hackup/WifiModem64/(threads)

Thread 1 (2020-01-26):

Board not connected

LordFennec, 2020-01-26:
Good morning.
I made a modemwifi board and loaded the latest firmware released (but I made them with both versions released), but when I try to connect to the home wifi, it always fails and does not connect. The configuration of the parameters are certainly correct.
On the ccmgs program I configured:
Modem type: user port 300-2400
Baud rate: 300
Duplex: full
Protocol: A punter

I made another type of modem with the nodemcu module and with these parameters everything works properly.

LordFennec, 2020-02-04:
Is there anyone who managed to make it work ??
