hackup/WifiModem64/WifiModem64.kicad_pcb

## KiCad design WifiModem64.kicad_pcb (2018-01-16)

Schematic: WifiModem64.sch

Parts:
C1: 100n; C_0805_HandSoldering
D1: B5819WS; D_SOD-323_HandSoldering
F1: 0.5A; R_1206_HandSoldering
J1: C64-UserPort; C64-User-Port-Female
J2: USB_B; USB_Micro-B
JP1: PwrSafety; GS2
JP2: CTS; GS2
JP3: RTS; GS2
JP4: SP1; GS2
JP5: SP2; GS2
JP6: PwrSrc; Pin_Header_Straight_1x03_Pitch2.54mm
LED1: WS2812B
Q1, Q2, Q3, Q4: BSS138; SOT-23_Handsoldering
R1, R2, R3, R4, R5, R6, R7, R8: 10k; R_0805_HandSoldering
SW1: Push; SW_Tactile_SPST_Angled_PTS645Vx58-2LFS
SW2: Reset; SW_Tactile_SPST_Angled_PTS645Vx58-2LFS
U1: WeMos_mini; D1_mini_board
U2: WeMos_D1_mini_OLED_Shield; D1_mini_OLED_Display

Connections:
+3V3: Q1.1, Q2.1, Q3.1, Q4.1, R1.1, R2.1, R3.1, R4.1, U1.16, U2.16 (3.3V)
+5V: C1.1, F1.1, JP1.1, LED1.1, R5.1, R6.1, R7.1, R8.1, U1.1, U2.1 (5V)
CTS: J1.D, JP2.1, Q1.2, R1.2
GND: C1.2, J1.1, J1.12, J1.A, J1.N, J2.4, J2.5, LED1.3, SW1.2, SW2.2, U1.2, U2.2 (GND)
unnamed: D1.1, F1.2
unnamed: D1.2, JP1.2, JP6.2
unnamed: J1.2, JP6.3
unnamed: J1.6, J1.L
unnamed: J2.1, JP6.1
RST: J1.3, SW2.1
RTS: J1.K, JP3.1, Q2.2, R2.2
SP1: J1.5, J1.M, JP4.1, Q3.2, R3.2
SP2: J1.7, J1.B, J1.C, JP5.1, Q4.2, R4.2
W_A0: U1.10, U2.10 (A0)
W_D0: U1.11, U2.11 (D0)
W_D1: U1.6, U2.6 (D1)
W_D2: U1.5, U2.5 (D2)
W_D3: SW1.1, U1.4, U2.4 (D3)
W_D4: U1.3, U2.3 (D4)
W_D5: LED1.4, U1.12, U2.12 (D5)
W_D6: JP2.2, Q1.3, R5.2, U1.13, U2.13 (D6)
W_D7: JP3.2, Q2.3, R6.2, U1.14, U2.14 (D7)
W_D8: U1.15, U2.15 (D8)
W_RST: U1.9, U2.9 (Rst)
W_RX: JP4.2, Q3.3, R7.2, U1.7, U2.7 (Rx)
W_TX: JP5.2, Q4.3, R8.2, U1.8, U2.8 (Tx)

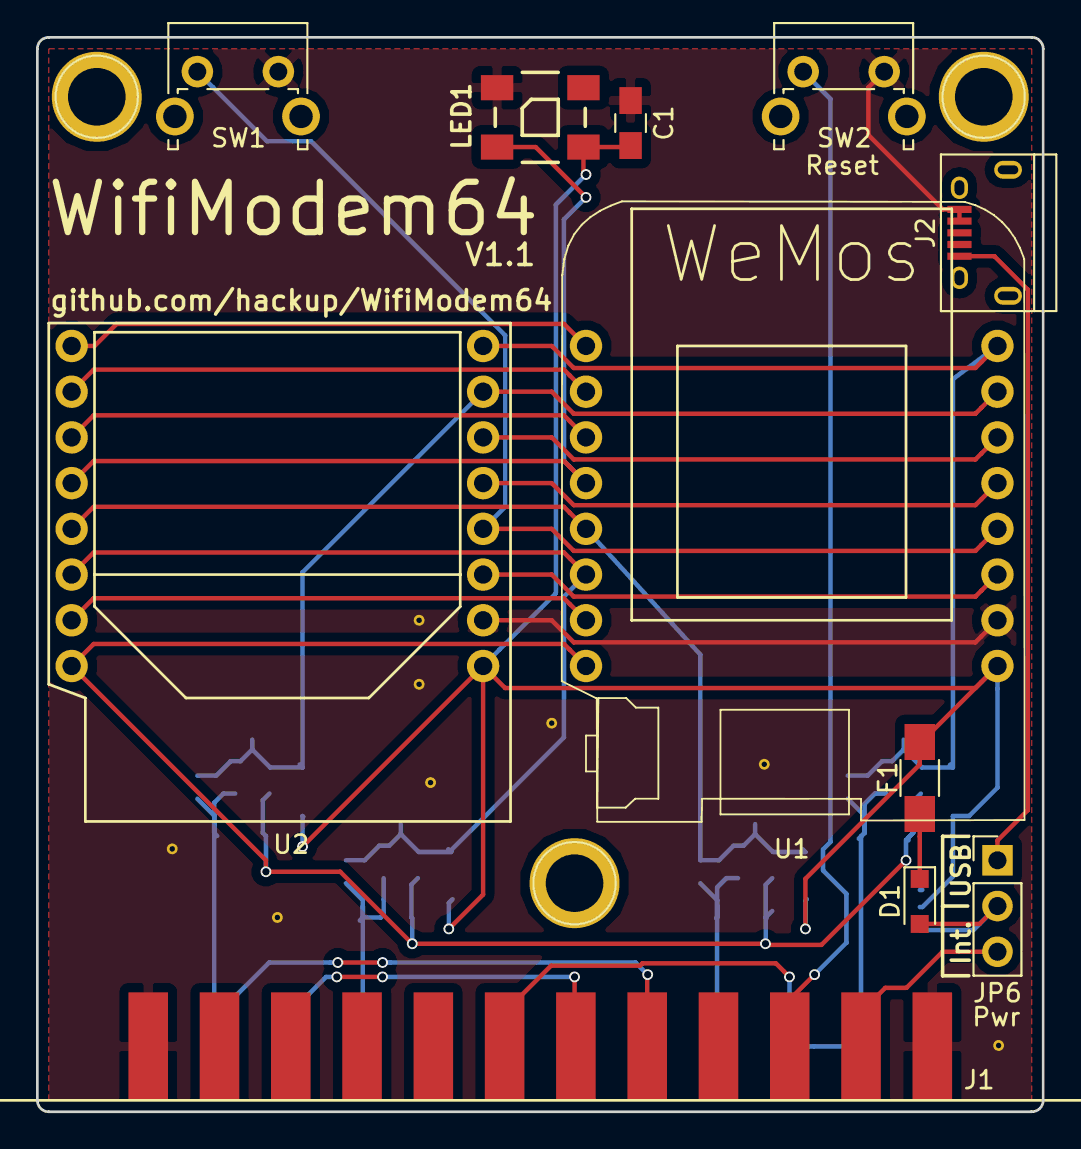
[picture p1: board WifiModem64.kicad_pcb from above]

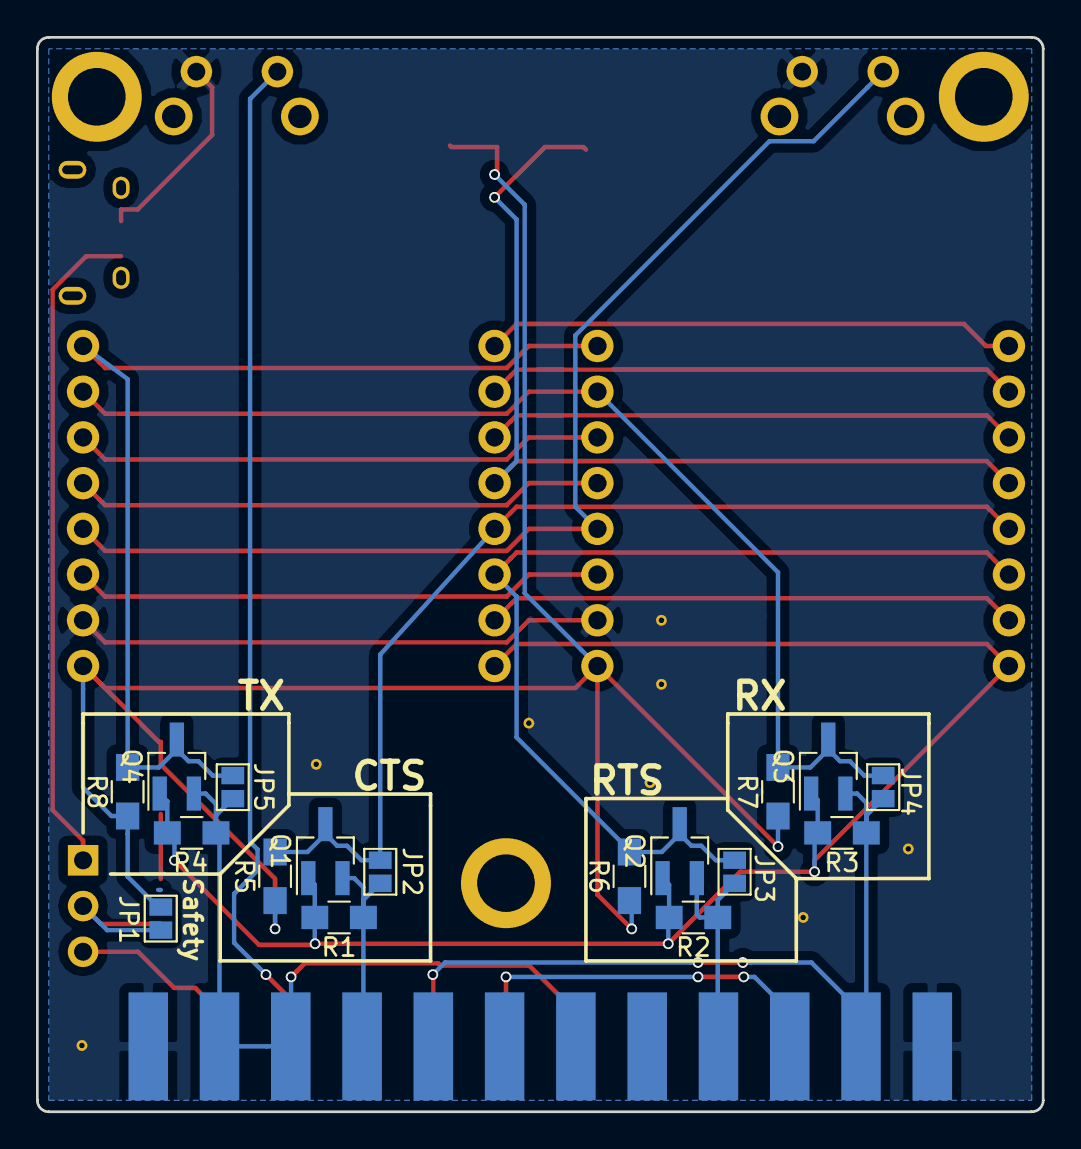
[picture p2: board WifiModem64.kicad_pcb from below]

Board: 2 copper layers, 55.9 x 59.7 mm, 28 parts (17 on the bottom side), 26 nets.
