hackup/WifiModem64/(commit log)

2017-12-16 Initial commit.
    [WifiModem64.kicad_pcb, WifiModem64.sch]
2017-12-17 Optimized silk screen.
    [WifiModem64.kicad_pcb]
2017-12-18 Added LED and mounting holes.
    [WifiModem64.kicad_pcb, WifiModem64.sch]
2017-12-18 Added optional USB power supply.
    [WifiModem64.kicad_pcb, WifiModem64.sch]
2017-12-18 First Gerber plot.
    [WifiModem64.kicad_pcb]
2017-12-18 Added Y dimension.
    [WifiModem64.kicad_pcb]
2017-12-18 Added pull-down resistor on GPIO15 that is needed for internal flash boot.
    [WifiModem64.kicad_pcb, WifiModem64.sch]
2017-12-18 Pull down resistor is not optional so it should be through hole.
    [WifiModem64.kicad_pcb, WifiModem64.sch]
2017-12-19 Keep gerber dir.
2017-12-25 Upgraded project files, modfied resistor footprint.
    [WifiModem64.kicad_pcb]
2017-12-26 Freed GPIO15 and fixed footprints.
    [WifiModem64.kicad_pcb, WifiModem64.sch]
2017-12-26 WS2812b not working on D0.
    [WifiModem64.kicad_pcb, WifiModem64.sch]
2018-01-15 Revision bump.
    [WifiModem64.kicad_pcb, WifiModem64.sch]
2018-01-16 Version 1.1 gerber export.
    [WifiModem64.kicad_pcb]
